pkuniec/kicad/plugins/FillArea.png

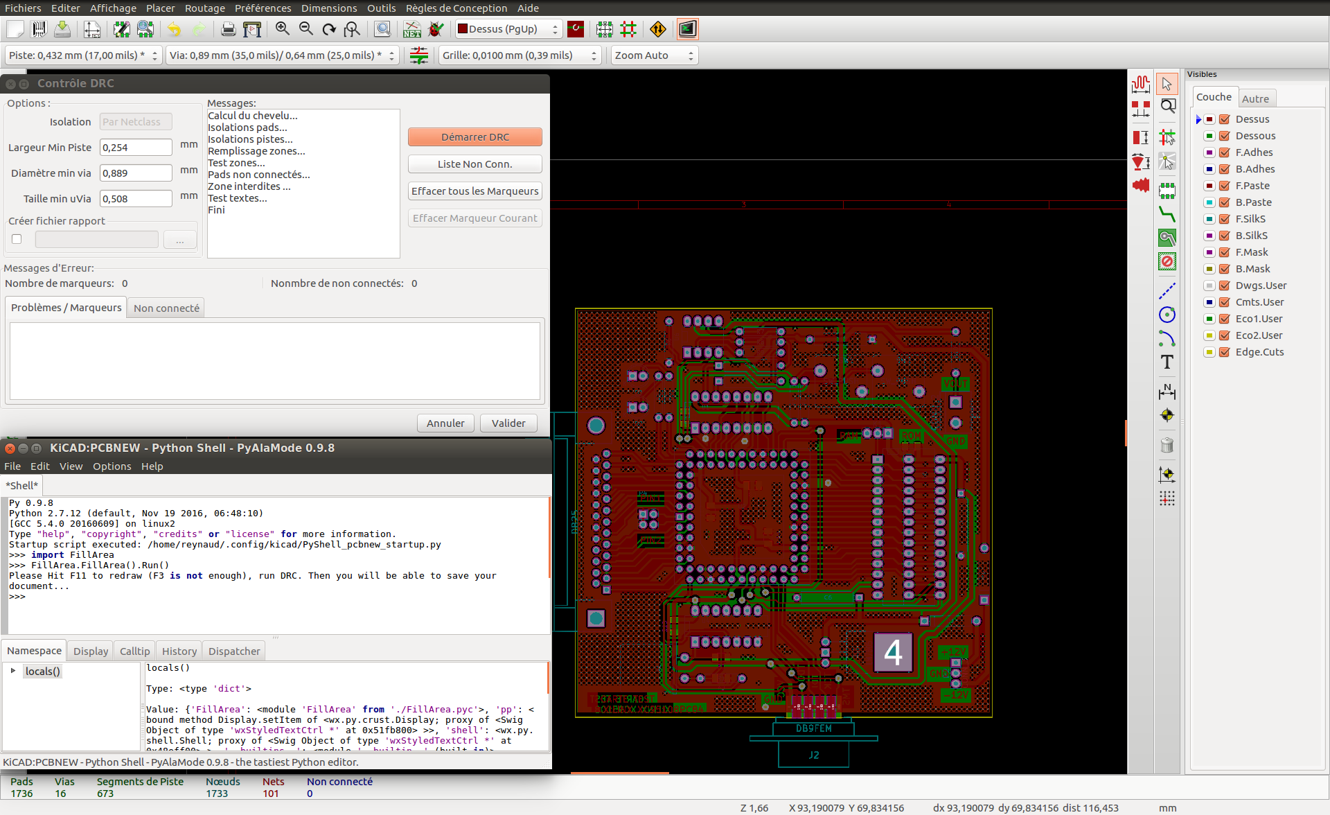
plugins/FillArea.png
