pkuniec/kicad/Parts.txt

Temp. sensors:
TMP236A
TMP75A - OK
SD5075
STLM20W87F

DC/DC:
HX3406
JW5211
SY8089
ME2188C50M5G

uC:
PY32F002A [ARM Cortex M0+]
CH32V003F4U6 [RISC-V]

FLASH:
W25Q16JVUXIQ, W25Q16JVSSIQ

LDO:
SPX3819M5 (C9055)
