pkuniec/kicad/(commit log)

2023-08-07 Dodanie templates
    [14_pin.kicad_sch, 30_pin.kicad_sch]
2023-11-19 New footprint for connectors
2024-02-04 Conn 1,5mm 10pin, 6 pin
